formatc1702/TrainTimes/hardware/Inkscape/Manufacturing/TrainTimes v3 Laser Cut Templafe Preview.pdf

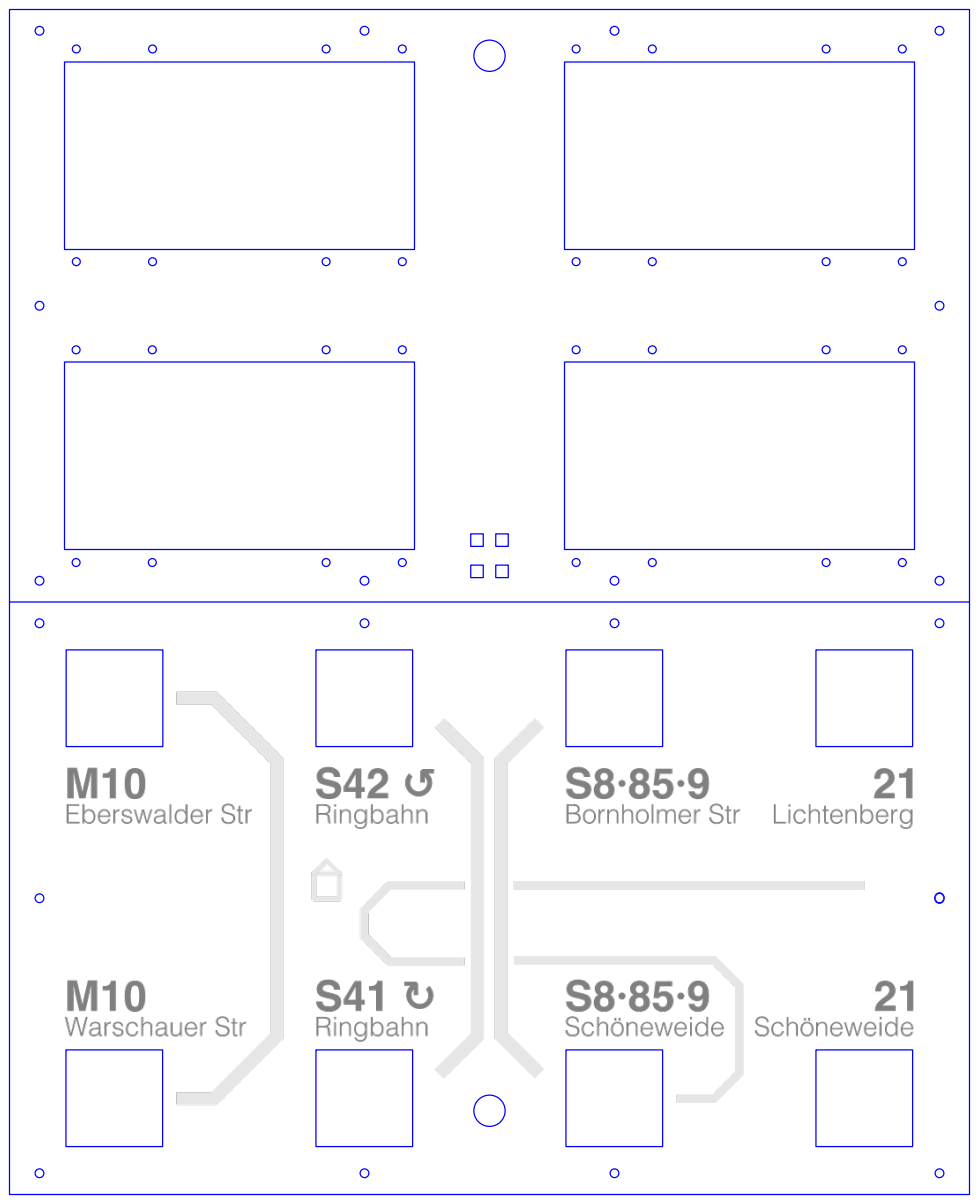
[picture p1: page 1]
