formatc1702/TrainTimes/hardware/Inkscape/Manufacturing/TrainTimes v3 Print Template.pdf

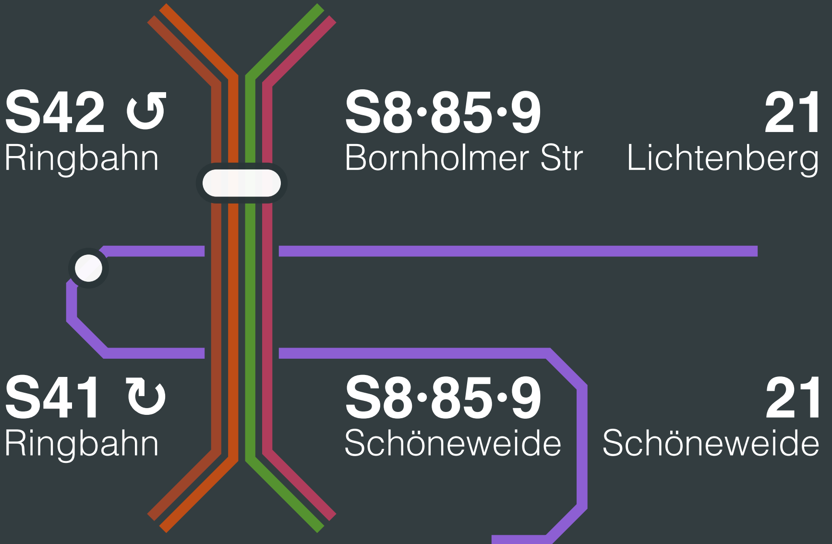
[picture p5: figure]
Ringbahn; Bornholmer Str; Schöneweide Schöneweide; Lichtenberg

M10
Warschauer Str

M10
Eberswalder Str
