formatc1702/TrainTimes/firmware/traintimes-micropython/src/wificonfig.template.txt

YourWiFiSSIDHere
YourWiFiPasswordHere
# insert your SSID/password, rename this file to wificonfig.txt and remove this line
