formatc1702/TrainTimes/firmware/traintimes-arduino/src/displaychars.h

const char numbers[10][8] ={
  { // 0
    0B00000000,
    0B00001110,
    0B00001010,
    0B00001010,
    0B00001010,
    0B00001010,
    0B00001110,
    0B00000000
  },
  { // 1
    0B00000000,
    0B00000010,
    0B00000110,
    0B00000010,
    0B00000010,
    0B00000010,
    0B00000010,
    0B00000000
  },
  { // 2
    0B00000000,
    0B00001100,
    0B00000010,
    0B00000010,
    0B00000100,
    0B00001000,
    0B00001110,
    0B00000000
  },
  { // 3
    0B00000000,
    0B00001100,
    0B00000010,
    0B00001100,
    0B00000010,
    0B00000010,
    0B00001100,
    0B00000000
  },
  { // 4
    0B00000000,
    0B00000010,
    0B00000110,
    0B00001010,
    0B00001110,
    0B00000010,
    0B00000010,
    0B00000000
  },
  { // 5
    0B00000000,
    0B00001110,
    0B00001000,
    0B00001110,
    0B00000010,
    0B00000010,
    0B00001100,
    0B00000000
  },
  { // 6
    0B00000000,
    0B00000110,
    0B00001000,
    0B00001110,
    0B00001010,
    0B00001010,
    0B00001110,
    0B00000000
  },
  { // 7
    0B00000000,
    0B00001110,
    0B00000010,
    0B00000010,
    0B00000100,
    0B00000100,
    0B00000100,
    0B00000000
  },
  { // 8
    0B00000000,
    0B00001110,
    0B00001010,
    0B00001110,
    0B00001010,
    0B00001010,
    0B00001110,
    0B00000000
  },
  { // 9
    0B00000000,
    0B00001110,
    0B00001010,
    0B00001110,
    0B00000010,
    0B00000010,
    0B00001100,
    0B00000000
  }
};
// */
const char icons[7][8] ={
  { // blank
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
  },
  {
    0B00011100,
    0B00000010,
    0B00000001,
    0B10000001,
    0B10000001,
    0B10000001,
    0B01000010,
    0B00111100
  },
  {
    0B00001100,
    0B00000010,
    0B10000001,
    0B10000001,
    0B10000001,
    0B10000001,
    0B01000010,
    0B00111100
  }
}; // */
