formatc1702/TrainTimes/firmware/traintimes-arduino/src/leds.h

#ifndef __LEDS_H
#define __LEDS_H

void InitDisplay();
void SleepDisplays();
void AnimateLoading();
void SetDisplayDepartures();
void SetAllDisplaysFrameFull       (                   int FrameNumber);
void SetDisplayFrameFull           (int DisplayNumber, int FrameNumber);
void SetAllDisplaysVerticalSplit   (                   int FrameNumber1, int FrameNumber2, int Split);
void SetDisplayFrameVerticalSplit  (int DisplayNumber, int FrameNumber1, int FrameNumber2, int Split);
void SetAllDisplaysHorizontalSplit (                   int FrameNumber1, int FrameNumber2, int Split);
void SetDisplayFrameHorizontalSplit(int DisplayNumber, int FrameNumber1, int FrameNumber2, int Split);
void SetFrameValueInt              (int DisplayNumber, int FrameNumber, int Value);
void SetFrameIcon                  (int DisplayNumber, int FrameNumber, int Value);
void WriteAllDisplays();
#endif
