formatc1702/TrainTimes/(commit log)

2016-10-15 Add EAGLE files
    [traintimes.brd, traintimes.sch]
2016-10-15 Add Arduino code
2016-10-23 Prepare for printing
2016-11-26 MicroPython Socket ReadLine working
2016-11-26 At least now the error is fixed
    Use print() function instead of print statement
2016-11-26 Woohoo! Works!
    Missing: Get server time, calculate time until departures, format for arduino, clean up etc
2016-11-26 Add wificonfig.txt for SSID+password
    [wificonfig.template.txt]
2016-11-26 Less printing
2016-11-26 Added main.py to avoid error message...
    [main.py]
2016-11-27 Comment out display test at startup (all LEDs on)
2016-11-27 Reduce WiFi UART timeout
2017-02-10 Add rotating ‘loading’ screen
2017-02-10 Implement CHPD (ESP-01) / RST (NodeMCU) pin functionality
2017-02-10 Semi-working code (Train Time parsing works, display frames are not updated)
2017-02-10 Archive old Arduino firmware and Lua script (replaced by MicroPython)
    [displaychars.h]
2017-02-13 Filter out results < 60s (including 0, which breaks Arduino’s ParseInt)
2017-02-17 Add delay on ESP8266 TX side and loosen UART timeout on Arduino RX side to reduce problems
    [main.py, wifi.cpp]
2017-02-17 Implement ESP8266 deep sleep after successful transmission (or sure failure)
    [main.py]
2017-04-27 Attempt to reduce memory usage -> not working
    [main.py, vbbapi.py]
2017-04-28 Store Station IDs in text file, format output for Arduino
2017-09-22 Actualy print to UART
2017-09-22 Add small buffer between transmissions of each direction to allow Arduino to read its buffer
2018-04-03 Revert "Summer time has ended."
    This reverts commit 3bb42d2795b9464ed7cda3b8c78a28bc55e3fa24.
    [ntp.py]
2020-12-06 Add switch to select CET/CEST
2021-10-02 Add optional printing of VBB API response
2021-10-02 Rename directories, update .gitignore
    [traintimes.brd, traintimes.sch, wificonfig.template.txt]
2021-10-02 Restructure MicroPython firmware directory
    [wificonfig.template.txt]
2021-10-08 Adapt to ESP-32 board
2021-10-08 Replace instances of `.format()` with f-strings
    [main.py, server.py, vbbapi.py, wifi.py]
2021-10-08 Update UART pins for ESP32
